sushishinichi1/fpga-mic/src/fft_twiddle_rom.v

`default_nettype none

module fft_twiddle_rom (
    input  wire               clk,
    input  wire [6:0]         addr,
    output reg signed [15:0]  twiddle_real,
    output reg signed [15:0]  twiddle_imag
);

    // 256-point forward-FFT twiddles in signed Q1.15 format.
    reg signed [15:0] real_rom [0:127];
    reg signed [15:0] imag_rom [0:127];

    initial begin
        real_rom[0] = 16'sd32767;
        imag_rom[0] = 16'sd0;
        real_rom[1] = 16'sd32757;
        imag_rom[1] = -16'sd804;
        real_rom[2] = 16'sd32728;
        imag_rom[2] = -16'sd1608;
        real_rom[3] = 16'sd32678;
        imag_rom[3] = -16'sd2410;
        real_rom[4] = 16'sd32609;
        imag_rom[4] = -16'sd3212;
        real_rom[5] = 16'sd32521;
        imag_rom[5] = -16'sd4011;
        real_rom[6] = 16'sd32412;
        imag_rom[6] = -16'sd4808;
        real_rom[7] = 16'sd32285;
        imag_rom[7] = -16'sd5602;
        real_rom[8] = 16'sd32137;
        imag_rom[8] = -16'sd6393;
        real_rom[9] = 16'sd31971;
        imag_rom[9] = -16'sd7179;
        real_rom[10] = 16'sd31785;
        imag_rom[10] = -16'sd7962;
        real_rom[11] = 16'sd31580;
        imag_rom[11] = -16'sd8739;
        real_rom[12] = 16'sd31356;
        imag_rom[12] = -16'sd9512;
        real_rom[13] = 16'sd31113;
        imag_rom[13] = -16'sd10278;
        real_rom[14] = 16'sd30852;
        imag_rom[14] = -16'sd11039;
        real_rom[15] = 16'sd30571;
        imag_rom[15] = -16'sd11793;
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
        imag_rom[116] = -16'sd9512;
        real_rom[117] = -16'sd31580;
        imag_rom[117] = -16'sd8739;
        real_rom[118] = -16'sd31785;
        imag_rom[118] = -16'sd7962;
        real_rom[119] = -16'sd31971;
        imag_rom[119] = -16'sd7179;
        real_rom[120] = -16'sd32137;
        imag_rom[120] = -16'sd6393;
        real_rom[121] = -16'sd32285;
        imag_rom[121] = -16'sd5602;
        real_rom[122] = -16'sd32412;
        imag_rom[122] = -16'sd4808;
        real_rom[123] = -16'sd32521;
        imag_rom[123] = -16'sd4011;
        real_rom[124] = -16'sd32609;
        imag_rom[124] = -16'sd3212;
        real_rom[125] = -16'sd32678;
        imag_rom[125] = -16'sd2410;
        real_rom[126] = -16'sd32728;
        imag_rom[126] = -16'sd1608;
        real_rom[127] = -16'sd32757;
        imag_rom[127] = -16'sd804;
    end

    always @(posedge clk) begin
        twiddle_real <= real_rom[addr];
        twiddle_imag <= imag_rom[addr];
    end

endmodule

`default_nettype wire
