sushishinichi1/fpga-mic/src/fft_hann_window.v

`default_nettype none

module fft_hann_window (
    input  wire               clk,
    input  wire signed [17:0] sample_in,
    input  wire               sample_valid_in,
    input  wire [7:0]         sample_index,
    output reg signed [17:0]  sample_out,
    output reg                sample_valid_out
);

    reg signed [17:0] sample_reg;
    reg signed [15:0] coefficient;
    reg                    valid_reg;
    reg signed [15:0] coefficients [0:127];

    wire [7:0] mirrored_index = (sample_index < 8'd128) ?
                                sample_index : (8'd255 - sample_index);
    wire signed [33:0] window_product = sample_reg * coefficient;
    wire signed [33:0] scaled_product = window_product >>> 15;

    // Store one half because the 256-point Hann window is symmetric.
    initial begin
        coefficients[0] = 16'sd0;
        coefficients[1] = 16'sd5;
        coefficients[2] = 16'sd20;
        coefficients[3] = 16'sd45;
        coefficients[4] = 16'sd80;
        coefficients[5] = 16'sd124;
        coefficients[6] = 16'sd179;
        coefficients[7] = 16'sd243;
        coefficients[8] = 16'sd317;
        coefficients[9] = 16'sd401;
        coefficients[10] = 16'sd495;
        coefficients[11] = 16'sd598;
        coefficients[12] = 16'sd711;
        coefficients[13] = 16'sd833;
        coefficients[14] = 16'sd965;
        coefficients[15] = 16'sd1106;
        coefficients[16] = 16'sd1257;
        coefficients[17] = 16'sd1416;
        coefficients[18] = 16'sd1585;
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
        coefficients[125] = 16'sd32736;
        coefficients[126] = 16'sd32756;
        coefficients[127] = 16'sd32766;
        sample_reg = 18'sd0;
        coefficient = 16'sd0;
        valid_reg = 1'b0;
        sample_out = 18'sd0;
        sample_valid_out = 1'b0;
    end

    always @(posedge clk) begin
        sample_reg <= sample_in;
        coefficient <= coefficients[mirrored_index[6:0]];
        valid_reg <= sample_valid_in;
        sample_valid_out <= valid_reg;

        if (valid_reg)
            sample_out <= scaled_product[17:0];
    end

endmodule

`default_nettype wire
