sushishinichi1/fpga-mic/(commit log)

2026-07-23 First working Tang Nano 9K LED blink
2026-07-25 Add button-controlled LED toggle
2026-07-26 Add UART button press counter
2026-07-27 Add UART CSV logger and web monitor
    [count_log.csv]
2026-07-27 Limit web viewer to latest 100 log entries
    [count_log.csv]
2026-07-27 UART logger web monitor MVP
2026-07-28 Add bidirectional UART reset and web dashboard controls
    [serial_logger.py]
2026-07-28 Add UART counter reset and web control
    [press_counter.v, top.v]
2026-07-28 Add UART register access and web LED control
2026-07-28 Add web-controlled LED PWM brightness
2026-07-30 Add web-controlled PWM and SPI loopback support
2026-09-28 Fix audio UART handshake and add integration tests
    [audio_uart_path_tb.v, audio_uart_sender.v, top_audio_uart_tb.v, uart_heartbeat.v, uart_heartbeat_tb.v]
